ATR-Lab/Theater-Project/Documentation/Schematic_theater_0.1.1_2021-12-10.pdf

# STEPPER MOTOR 1

## GEAR MOTOR 1

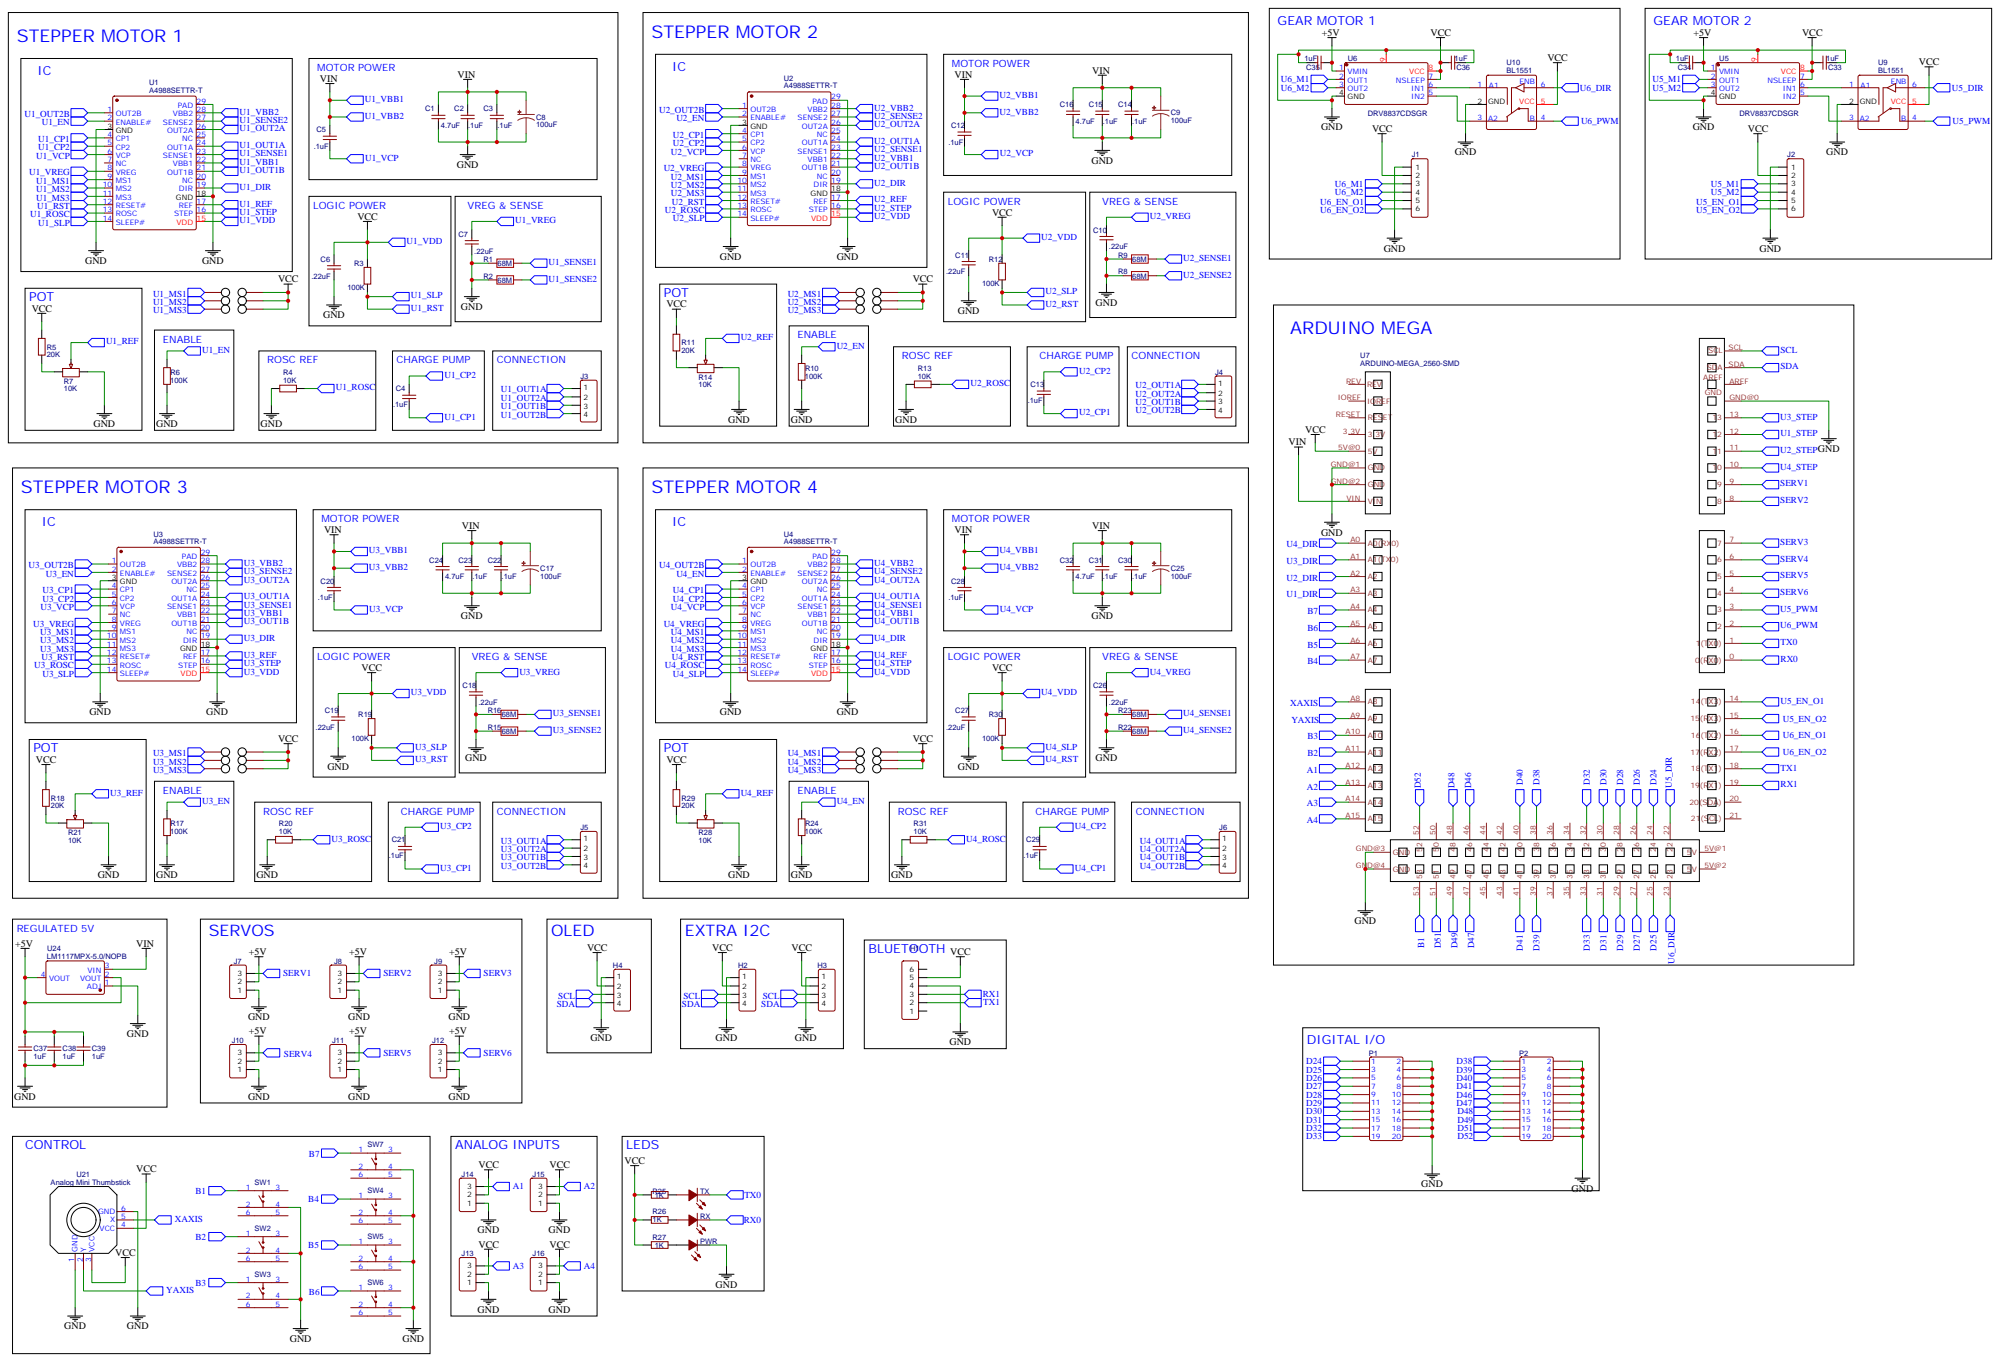
[picture p8: page 1]
