ATR-Lab/Theater-Project/Software/PCB_TestCode/Theater_Control_Test_rev_0.1.2/Issues List.txt

Issues:
Ordered displays have reverse GND/VCC
Need header pins for front ju
Maybe need heatsinks?
Should add pins for VCC, regulated 5v, and VIN

Board A
------
Stepper 1 - Working!
Stepper 2 - B2 bad (works when I press down on the chip pin)
Stepper 3 - All pins bad
Stepper 4 - Working!

Board B
------
Stepper 1 - Working!
Stepper 2 - B2 bad (works when pressing on chip pin)
Stepper 3 - B1 bad
Stepper 4 - Working!

Gear motors work except for motor 1 forward rotation
