ATR-Lab/Theater-Project/Software/PCB_TestCode/Puppet_Feature_Test_rev_0.1.1/pinmap.h

//Motor & Encoder Pins
#define motorDirPin_A           7
#define motorSpeedPin_A         5
#define motorEncoderOutput1_A   3
#define motorEncoderOutput2_A   4

#define motorDirPin_B           8
#define motorSpeedPin_B         6
#define motorEncoderOutput1_B   2
#define motorEncoderOutput2_B   17

//Servo Pins
#define servoPin_1  9
#define servoPin_2  10
#define servoPin_3  11

//QTR Pins
#define QTR1  A1
#define QTR2  A2
#define QTR3  A3

//I2C - Lidar Pins
#define SDA A4
#define SCL A5
