ATR-Lab/Theater-Project/(commit log)

2021-09-22 Added basic test program for v0.1 of PCB
2021-12-12 Added stepper motor tests
2021-12-14 Changed stepper motor initializations to I/O bank pins
2022-01-26 Added theater pin documentation
2022-01-26 add schematic
